YigitSalihEmecen/PolarBot/cad/base_plate.stl

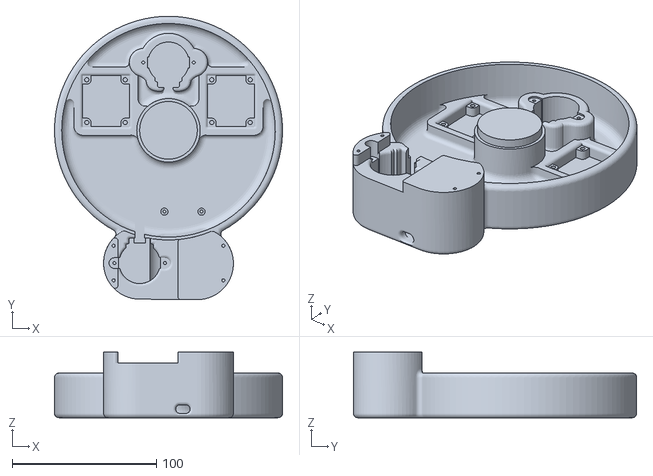
[picture p1: CAD file, 2026-09-24]
cad/base_plate.stl
158.0 x 196.3 x 45.4
