YigitSalihEmecen/PolarBot/cad/linear_cap.stl

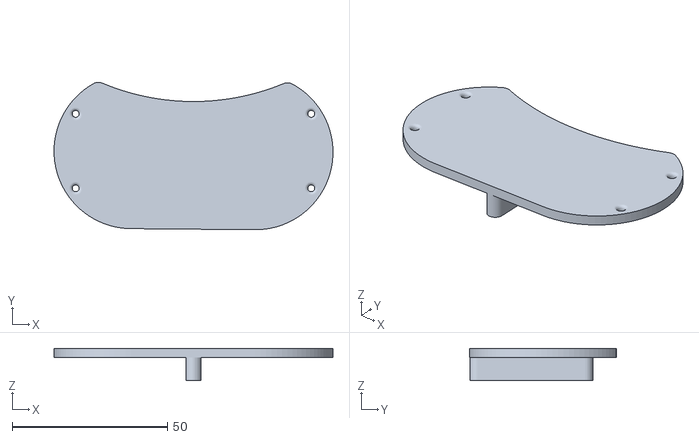
[picture p2: CAD file, 2026-09-24]
cad/linear_cap.stl
90.0 x 47.6 x 10.4
