YigitSalihEmecen/PolarBot/cad/linear_gear.stl

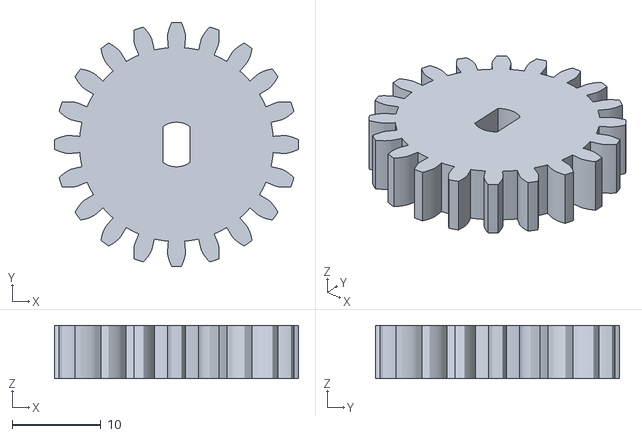
[picture p3: CAD file, 2026-09-24]
cad/linear_gear.stl
27.5 x 27.5 x 6.00
