YigitSalihEmecen/PolarBot/cad/build_plate.stl

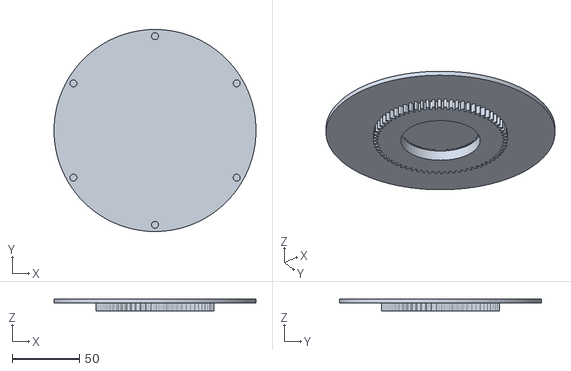
[picture p4: CAD file, 2026-09-24]
cad/build_plate.stl
150.0 x 150.0 x 9.00
