YigitSalihEmecen/PolarBot/cad/paper_clamp.stl

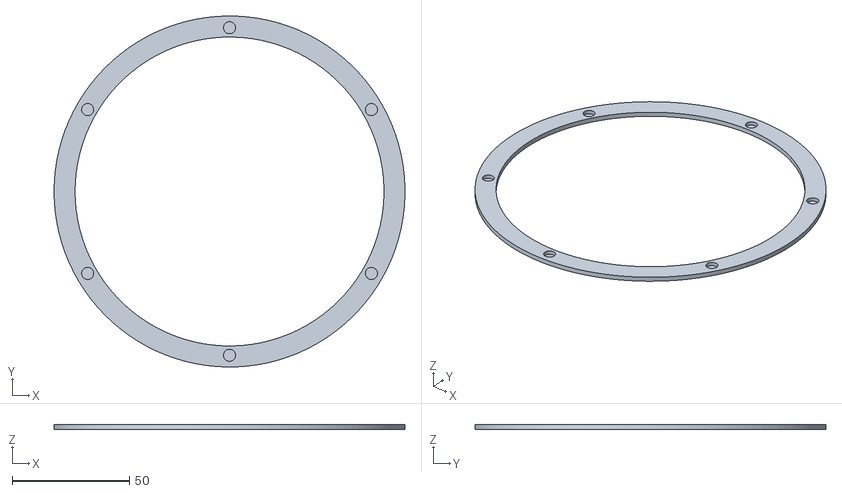
[picture p5: CAD file, 2026-09-24]
cad/paper_clamp.stl
150.0 x 150.0 x 2.00
