YigitSalihEmecen/PolarBot/cad/linear_rail.stl

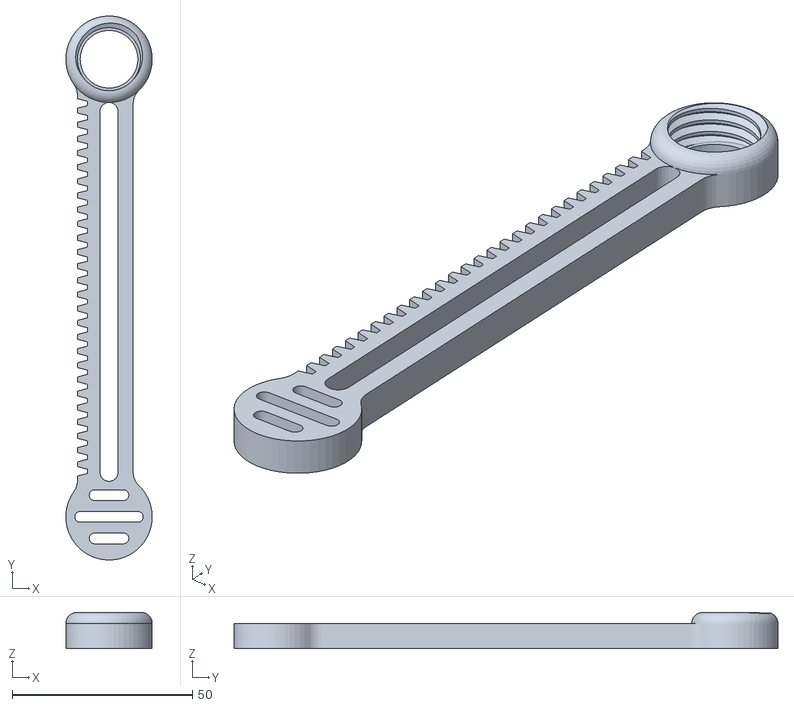
[picture p6: CAD file, 2026-09-24]
cad/linear_rail.stl
24.0 x 151.0 x 10.0
