YigitSalihEmecen/PolarBot/cad/pen_holder_cap.stl

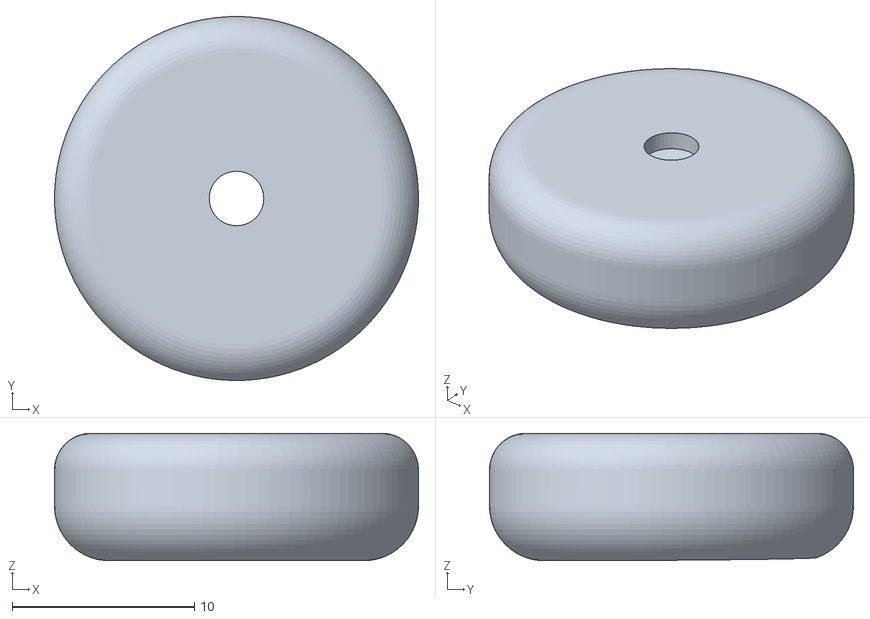
[picture p7: CAD file, 2026-09-24]
cad/pen_holder_cap.stl
20.0 x 20.0 x 7.00
