YigitSalihEmecen/PolarBot/cad/pen_holder_body.stl

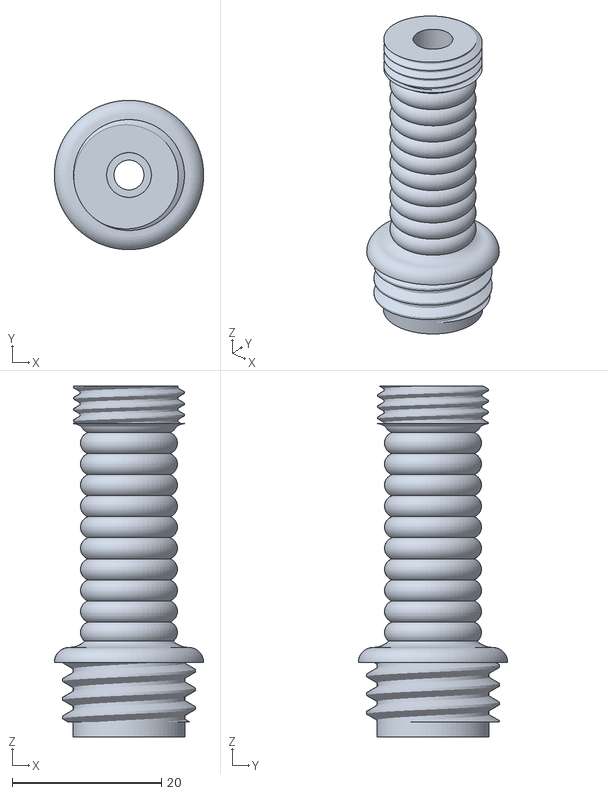
[picture p8: CAD file, 2026-09-24]
cad/pen_holder_body.stl
20.0 x 20.0 x 47.0
