YigitSalihEmecen/PolarBot/(list of files, cad)

Other CAD files:
cad/base_gear.stl
