YigitSalihEmecen/PolarBot/(commit log)

2026-09-24 Initial commit: PolarBot firmware, web app, CAD parts and docs
    [base_gear.stl, base_plate.stl, build_plate.stl, linear_cap.stl, linear_gear.stl, linear_rail.stl, linear_stabilizer_gear.stl, paper_clamp.stl]
2026-09-24 Fix web app to match firmware, update docs and README
    - Web app: use firmware step constants, track in-flight lines per 'ok',
    normalize G-code to absolute moves (works around G91/G28 firmware
    limitations), show pen-down travel moves in preview, fix status/button
    states, escape log output
    - Docs: correct constants, WiFi start, power, web app description
    - README: static architecture diagram, USB-only power, drop stabilizer gear
    - Remove unused linear_stabilizer_gear.stl
    [linear_stabilizer_gear.stl]
2026-09-24 Add MIT license, wiring diagram, limitations and roadmap
2026-11-04 Rework the web app in a calm, minimal design
    Warm paper, ink and one clay accent; serif headings, Inter text. Plain CSS
    with tokens replaces Tailwind from a CDN. Shape buttons draw their own
    G-code as icons, the preview renders at screen density with dashed travel
    moves, and connection state is a status dot. On HTTPS the page explains
    that it can only preview, and a blocked ws:// no longer throws.
    Adds a workflow that publishes web/ to gh-pages for GitHub Pages.
